Gustavo-Nogueira/Controlador-PID/project.jpeg

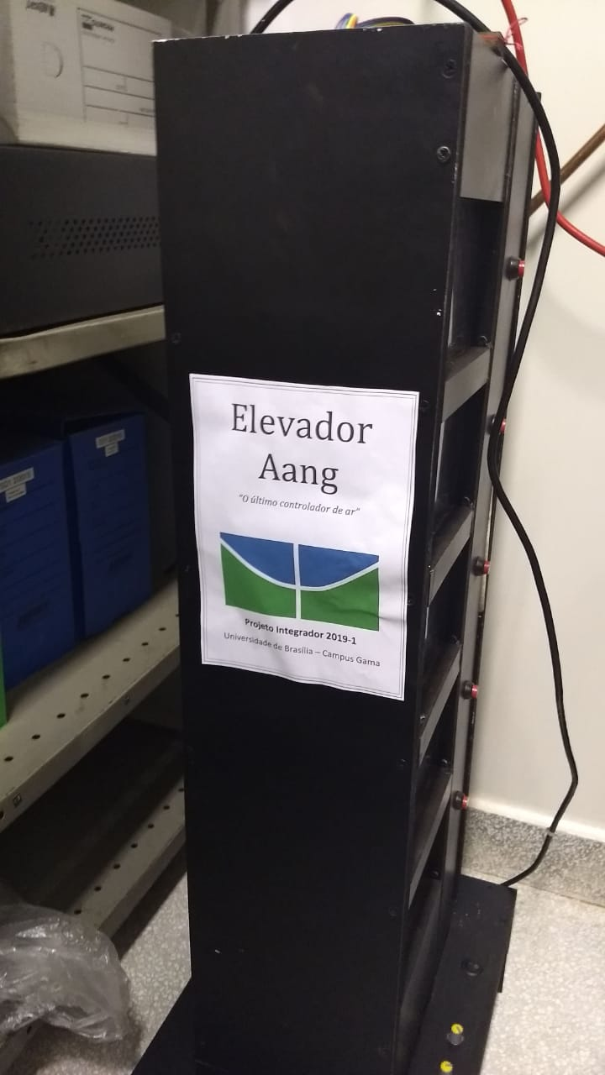
project.jpeg
