Gustavo-Nogueira/Controlador-PID/(commit log)

2019-05-10 Create ESP32_Web_Server.ino
    Template para código arduino IDE
2019-05-11 Código da Esp32
2019-05-13 Update das informações de algumas funções
2019-06-08 Atualização Versão Integrada + Pendências de Baixa Urgência
2019-06-10 Atualizações para cada status do sistema
2019-06-11 Atualização: Tempo de descida + Overshoot
2019-06-13 Create MultEnconder.ino
    Código para inserção das constantes de controle.
2019-06-30 Integração & funções testadas na estrutura
    Pinos atualizados, seletor de andar e PWM.
2019-07-04 PID Code Direct
2019-07-05 Add new pid
2019-10-21 Atualizando para versão de entregue do projeto.
2019-10-21 Adição de mídias para o readme.
2019-10-21 Adição dos documentos do projeto(Pontos de controle).
